ypwhs/autoAirConditioner/README.md

#中央空调控制器

##[准备篇](Prepare.md)

介绍了需要准备的东西.

##[制作篇](howtodo.md)

介绍了制作的过程.

##[代码篇](Programming.md)

详细地讲解了代码.

##[使用篇](Use.md)

介绍了如何使用.

##最终效果

###使用前

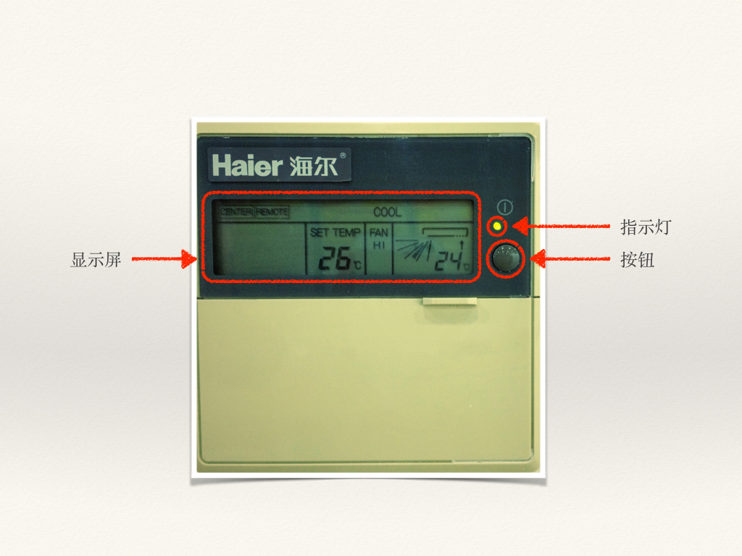
[picture p1: screen/airconditioner.jpg]


###使用后

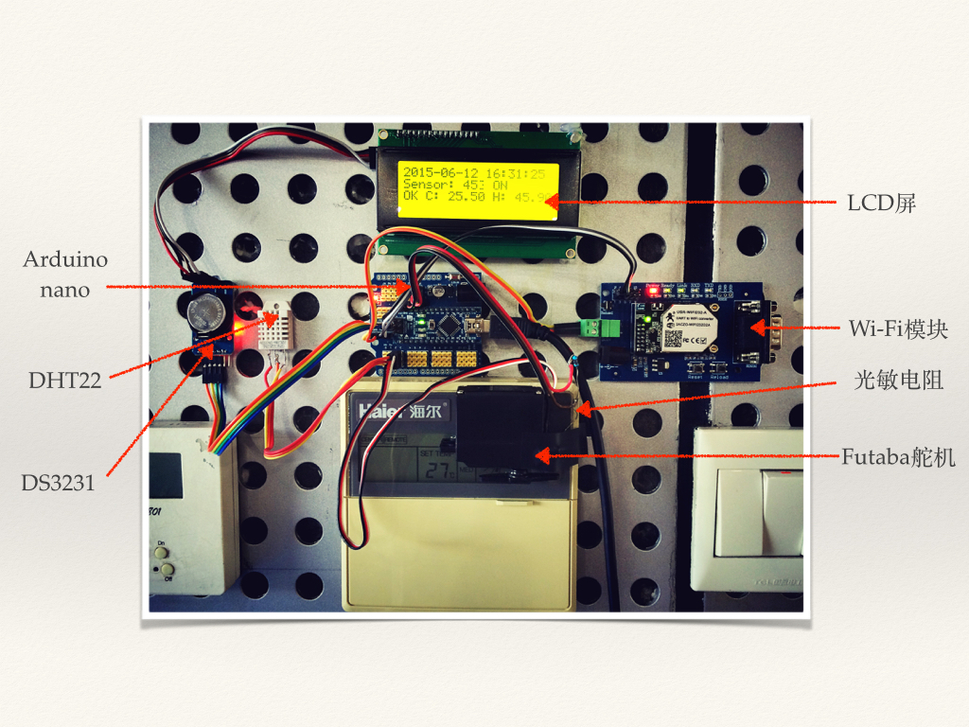
[picture p2: screen/IMG_1612.JPG]


###手机app

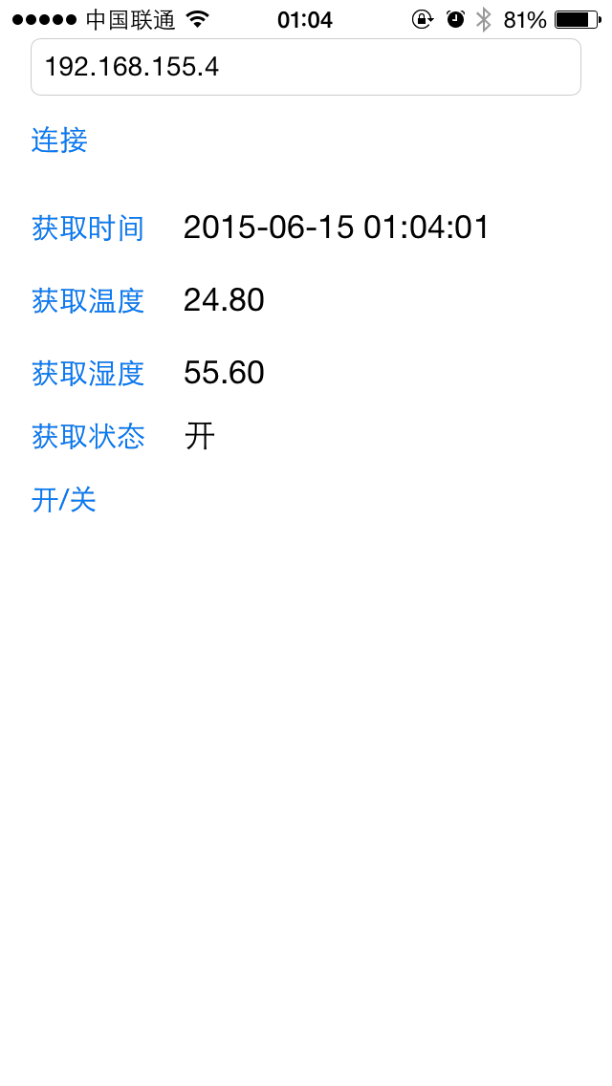
[picture p3: screen/IMG_1667.PNG]
