ypwhs/autoAirConditioner/Prepare.md

#中央空调控制器-准备篇

##原材料购买

| 名称	| 图片	| 价格	| 链接	|
|----	|----	|----	|----	|
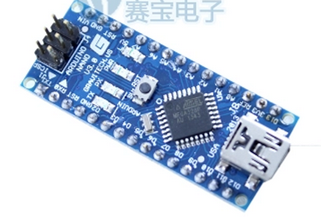
[picture p4: screen/nano.png]
| Arduino	| 	| 24	| [Arduino Nano](http://item.taobao.com/item.htm?spm=a1z10.5-c.w4002-1685197539.15.8GlHtd&id=15733833441)	|
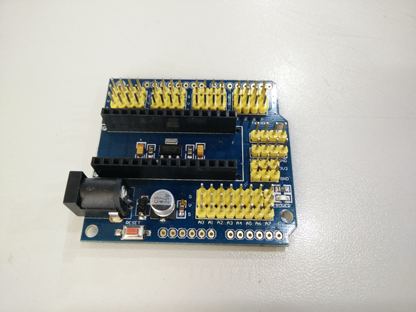
[picture p5: screen/kzb.png]
| 扩展板	|		| 10	| [扩展板](http://item.taobao.com/item.htm?spm=a1z10.3-c.w4002-1685211022.18.tIa5g1&id=21678604895)	|
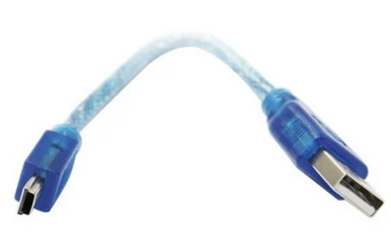
[picture p6: screen/miniusb.png]
| mini USB线	| 	| 2.5	| [mini USB](http://item.taobao.com/item.htm?spm=a1z10.5-c.w4002-1685197539.15.jVZ8R7&id=40351849521)	|
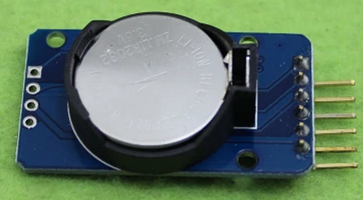
[picture p7: screen/ds3231.png]
| DS3231	| 	| 5	| [DS3231](http://item.taobao.com/item.htm?spm=a1z10.5-c.w4002-1685197539.9.zM67k6&id=37488105948)	|
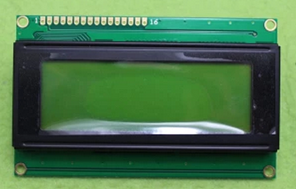
[picture p8: screen/2004.png]
| **I2C** LCD2004	| 	| 21	| [LCD2004](http://item.taobao.com/item.htm?spm=a1z10.5-c.w4002-1685197539.15.2V98uJ&id=19385040494)	|
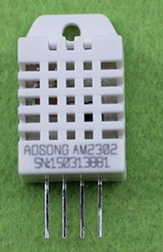
[picture p9: screen/dht.png]
| DHT22	| 	| 17	| [DHT22](http://item.taobao.com/item.htm?spm=a1z10.3-c.w4002-1685211022.11.7KKKOE&id=6322475249)	|
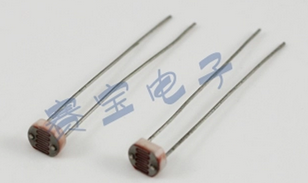
[picture p10: screen/gmdz.png]
| 光敏电阻	| 	| 1.2	| [光敏电阻](http://item.taobao.com/item.htm?spm=a1z10.5-c.w4002-1685197539.25.642x7C&id=12859015990)	|
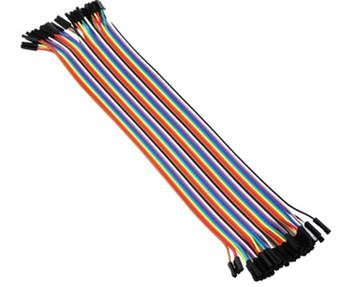
[picture p11: screen/dbx.png]
| 杜邦线	| 	| 3.5	| [杜邦线](http://item.taobao.com/item.htm?spm=a1z10.3-c.w4002-1685211022.14.6rCGUc&id=6203202913)	|
| FUTABA S3003	| 	| 55	| [S3003](http://item.taobao.com/item.htm?spm=a230r.1.14.24.It07lO&id=35577062480&ns=1&abbucket=14#detail)	|
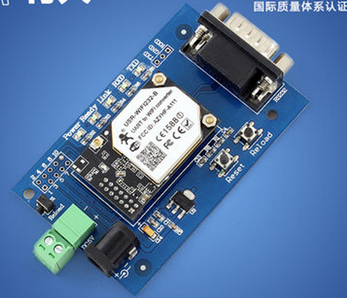
[picture p12: screen/wifi.png]
| WIFI模块(买内置天线的)	| 	| 144	| [WIFI](http://detail.tmall.com/item.htm?id=22288063406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)	|

##可能需要的工具和材料

* 焊台/电烙铁
* 焊锡丝
* 排针/排母
* 热熔胶枪
* 热熔胶棒
* 剪刀
* 剥线钳
* 斜口钳
* 尖嘴钳
* ABS板
* 钩刀
